akafliegslo/DragRake/(list of files, cad)

Other CAD files:
CAD/Drag Rake Assembly/91270A250_STL NONMARRING LOCKNUT WSPRING-LOCK WASHER.f3d
CAD/Drag Rake Assembly/92095A183_BUTTON HEAD HEX DRIVE SCREW.f3d
CAD/Drag Rake Assembly/Adafruit ESP8266 Feather_withPinheads.f3d
CAD/Drag Rake Assembly/Amphenol Pressure Sensor.f3d
CAD/Drag Rake Assembly/Carbon Frame.f3d
CAD/Drag Rake Assembly/DR Assembly V2.f3z
CAD/Drag Rake Assembly/Free stream tube.f3d
CAD/Drag Rake Assembly/Rake Body Drawing V2.f3z
CAD/Drag Rake Assembly/Rake Tube.f3d
CAD/Drag Rake Assembly/Tubing Connect.f3d
