akafliegslo/DragRake/CAD/DR_Assembly_V2_2020-Jan-13_07-56-52AM-000_CustomizedView37132953606.png

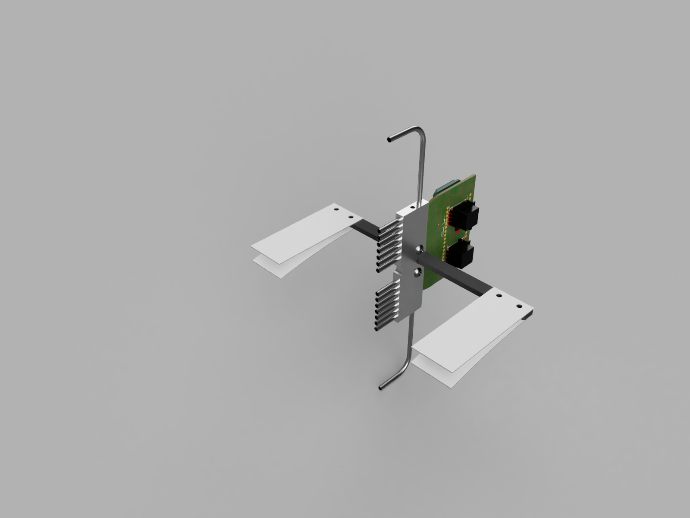
CAD/DR_Assembly_V2_2020-Jan-13_07-56-52AM-000_CustomizedView37132953606.png
