akafliegslo/DragRake/CAD/DR_Assembly_V2_2020-Jan-13_08-01-58AM-000_CustomizedView126981086.png

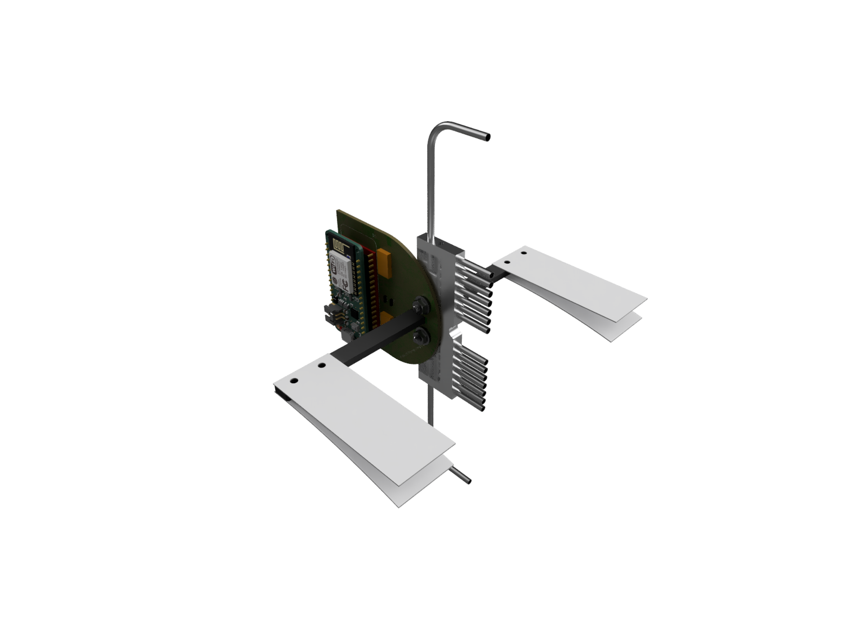
CAD/DR_Assembly_V2_2020-Jan-13_08-01-58AM-000_CustomizedView126981086.png
