akafliegslo/DragRake/Test Data and Analysis/AoA Analysis/Av_Pressure_vs_AoA.png

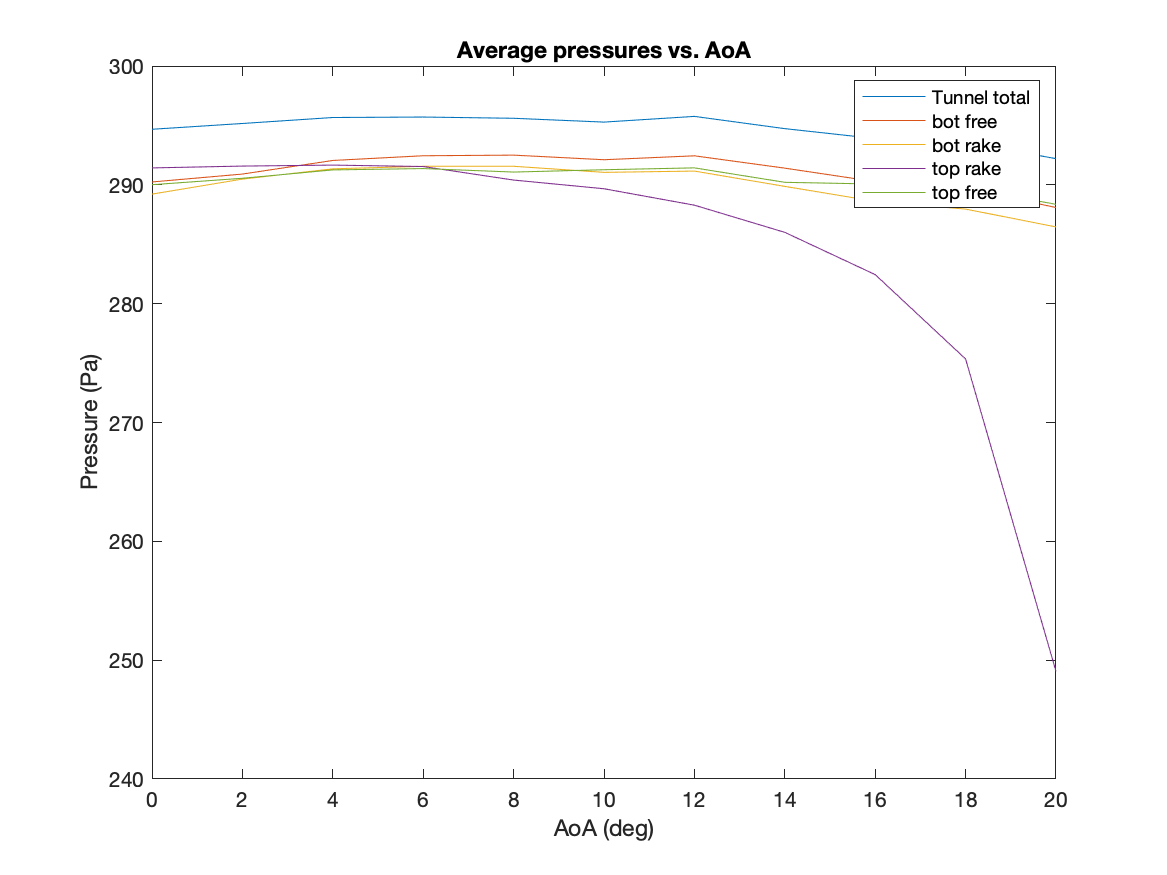
Test Data and Analysis/AoA Analysis/Av_Pressure_vs_AoA.png
