akafliegslo/DragRake/Test Data and Analysis/dr2_22_0d.png

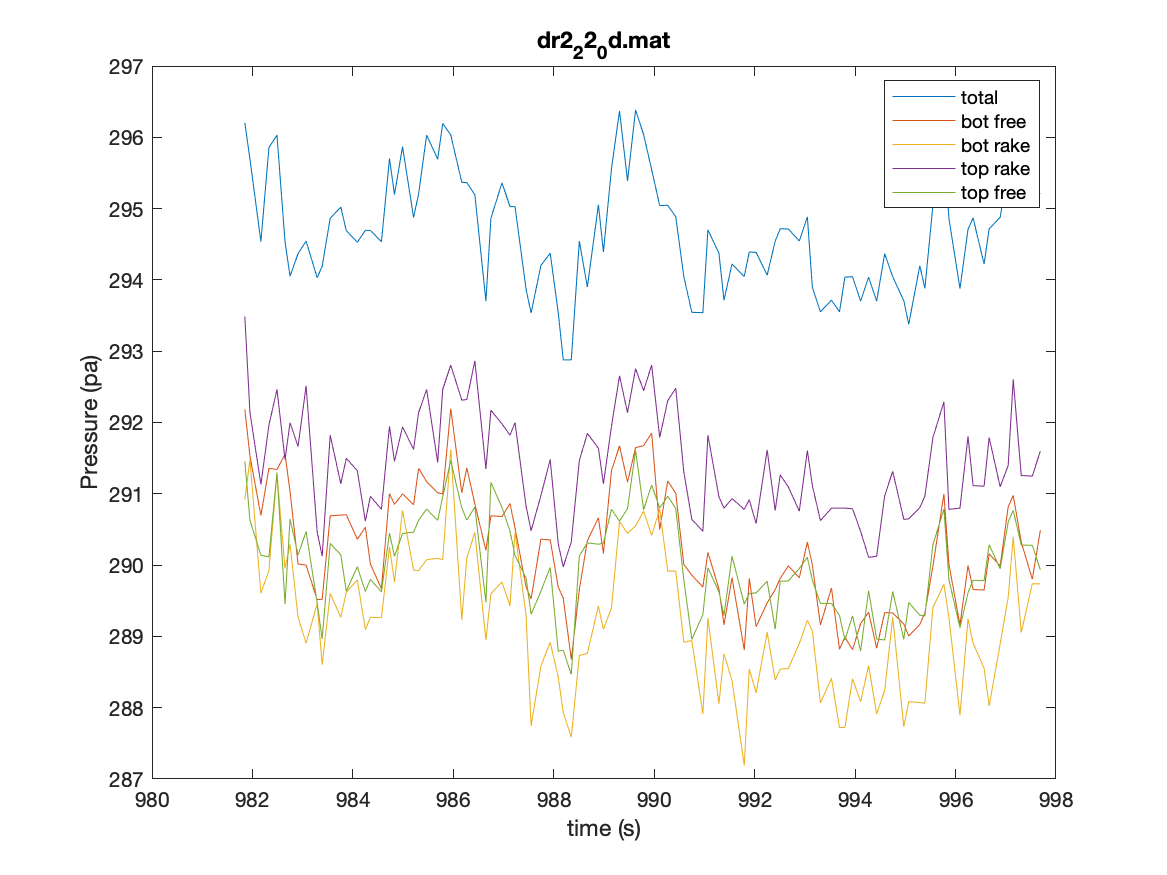
Test Data and Analysis/dr2_22_0d.png
