akafliegslo/DragRake/Test Data and Analysis/dr2_22_2d.png

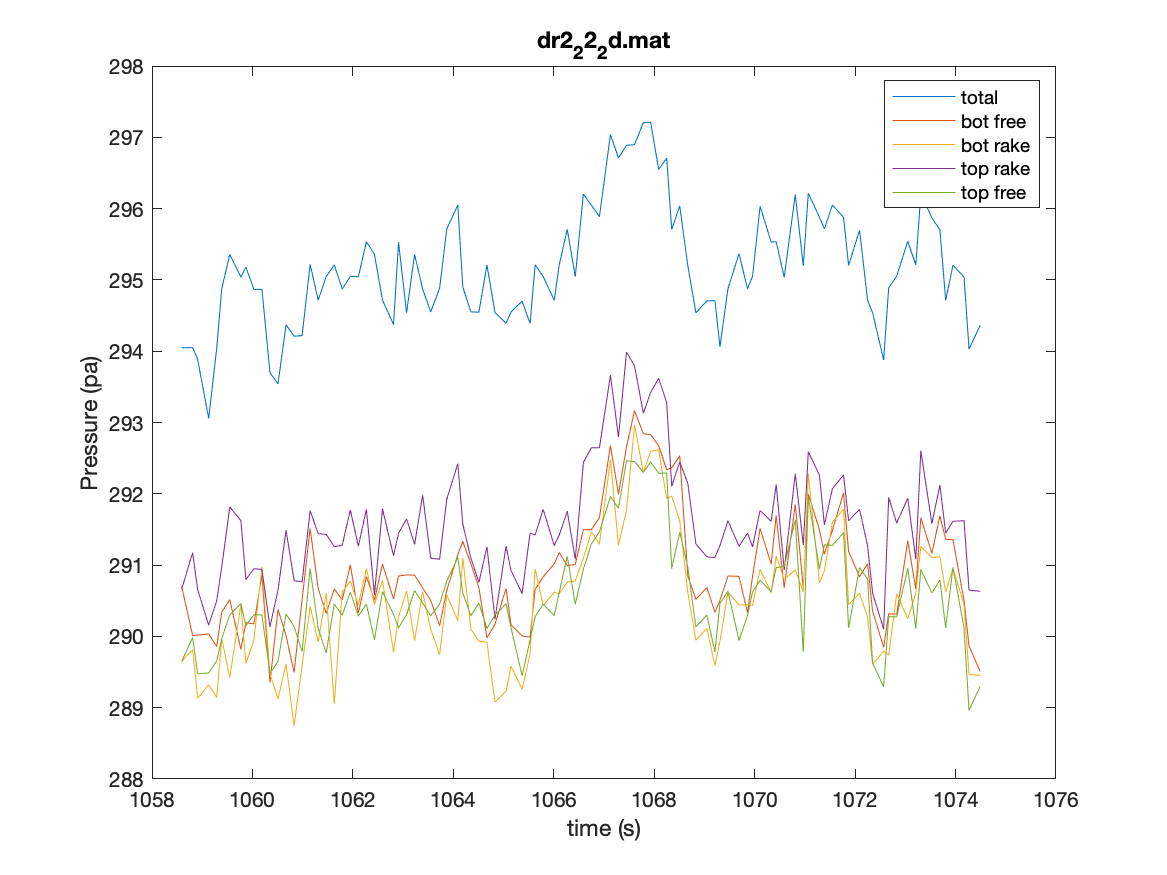
Test Data and Analysis/dr2_22_2d.png
