akafliegslo/DragRake/Test Data and Analysis/dr2_22_4d.png

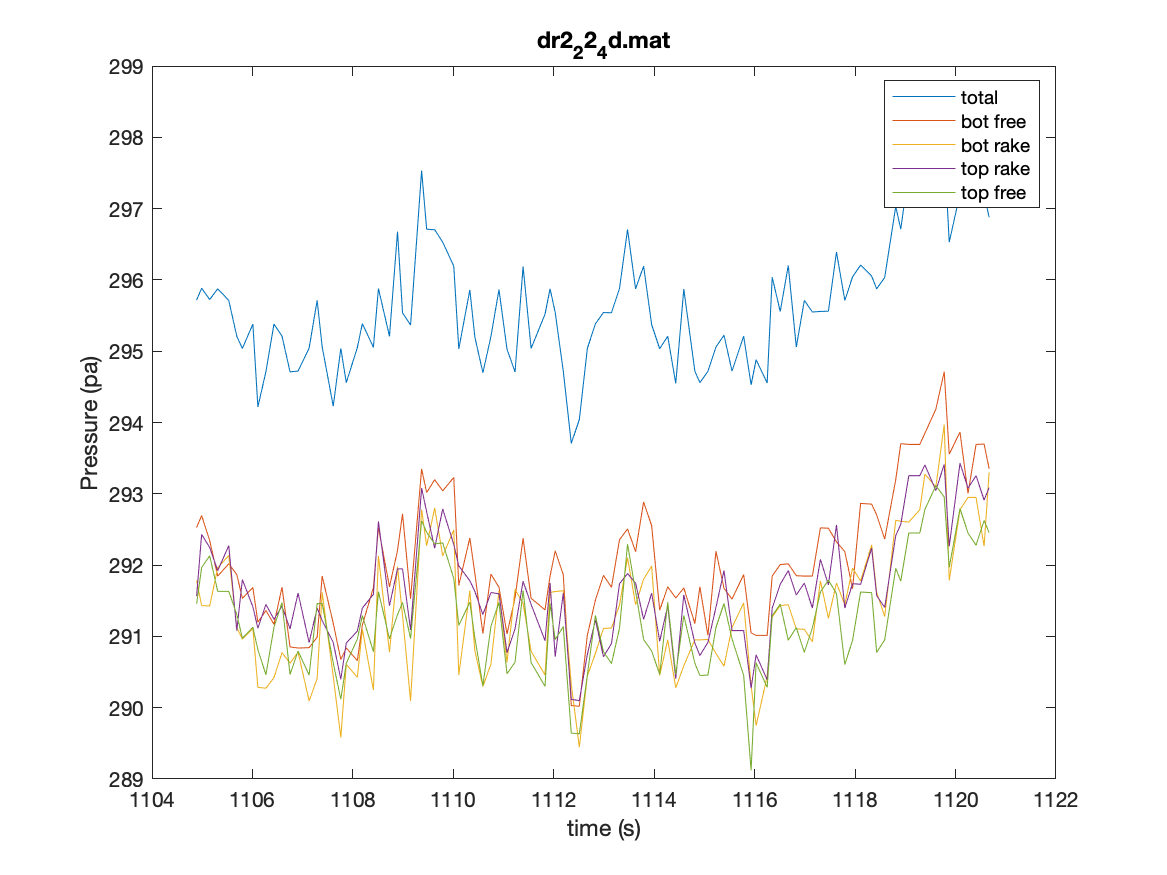
Test Data and Analysis/dr2_22_4d.png
