akafliegslo/DragRake/Test Data and Analysis/dr2_22_6d.png

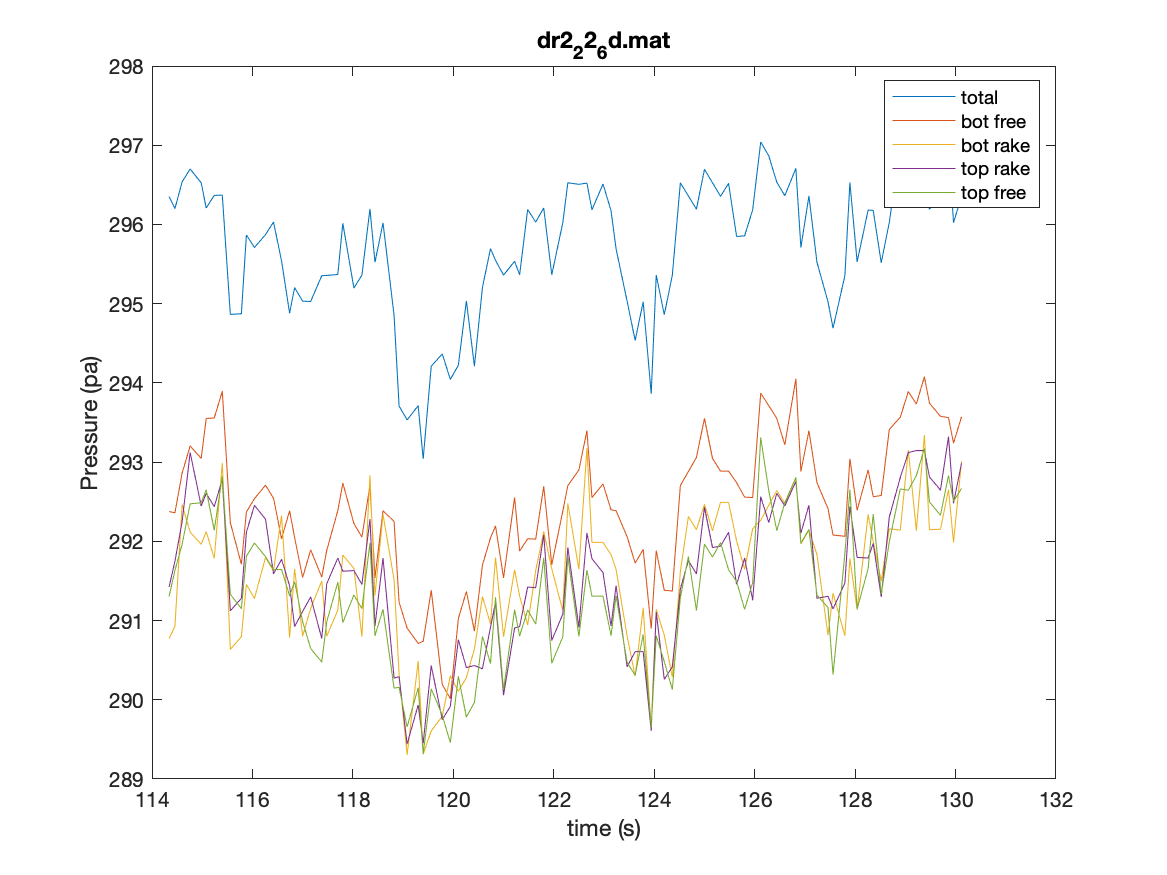
Test Data and Analysis/dr2_22_6d.png
