akafliegslo/DragRake/Test Data and Analysis/dr2_22_8d.png

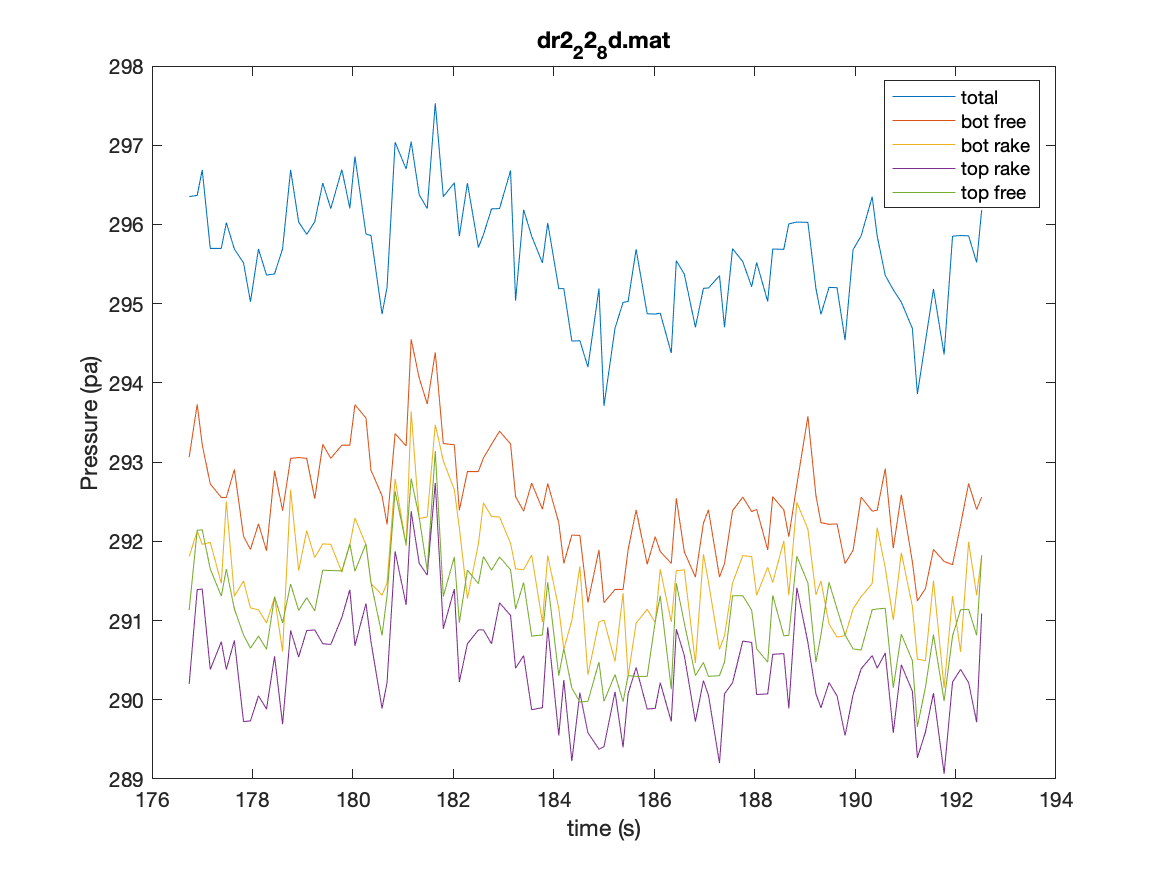
Test Data and Analysis/dr2_22_8d.png
