akafliegslo/DragRake/Test Data and Analysis/dr2_22_10d.png

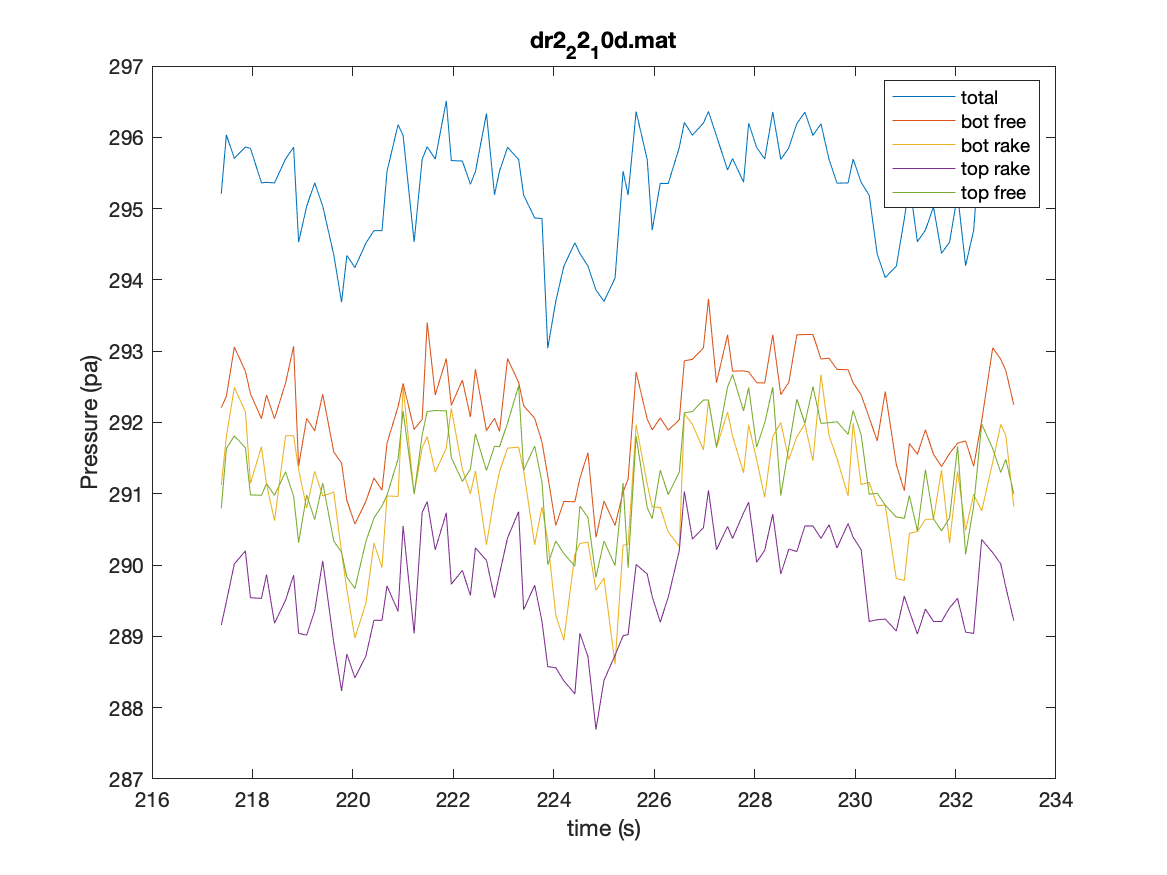
Test Data and Analysis/dr2_22_10d.png
