akafliegslo/DragRake/Test Data and Analysis/dr2_22_12d.png

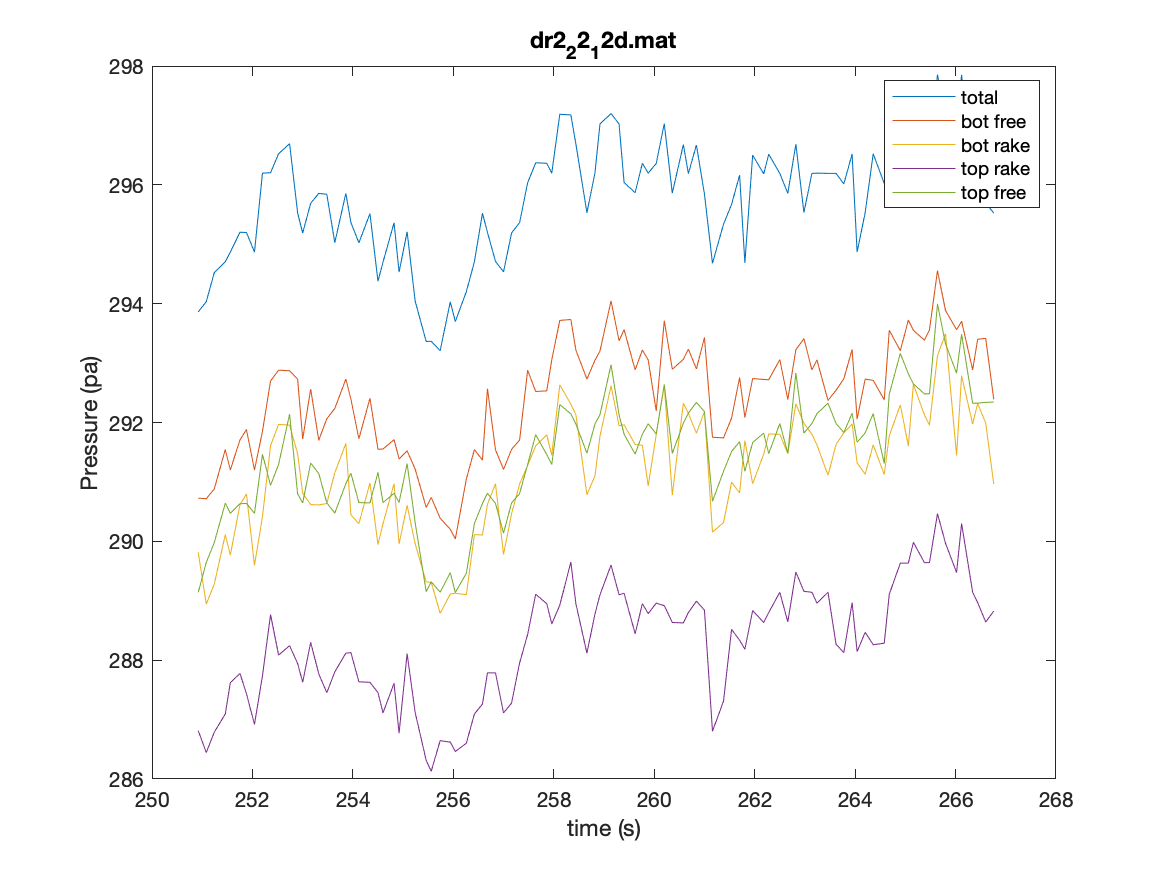
Test Data and Analysis/dr2_22_12d.png
