akafliegslo/DragRake/Test Data and Analysis/dr2_22_14d.png

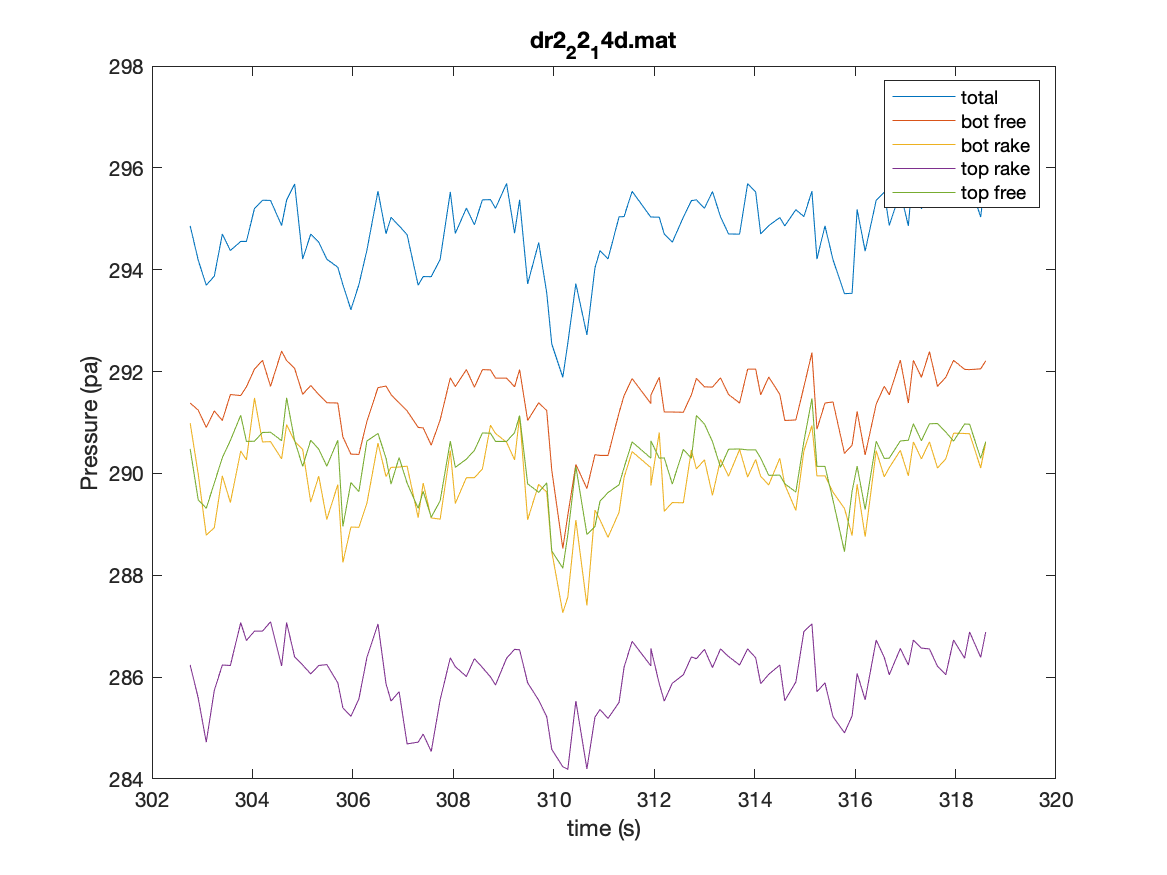
Test Data and Analysis/dr2_22_14d.png
