akafliegslo/DragRake/Test Data and Analysis/dr2_22_16d.png

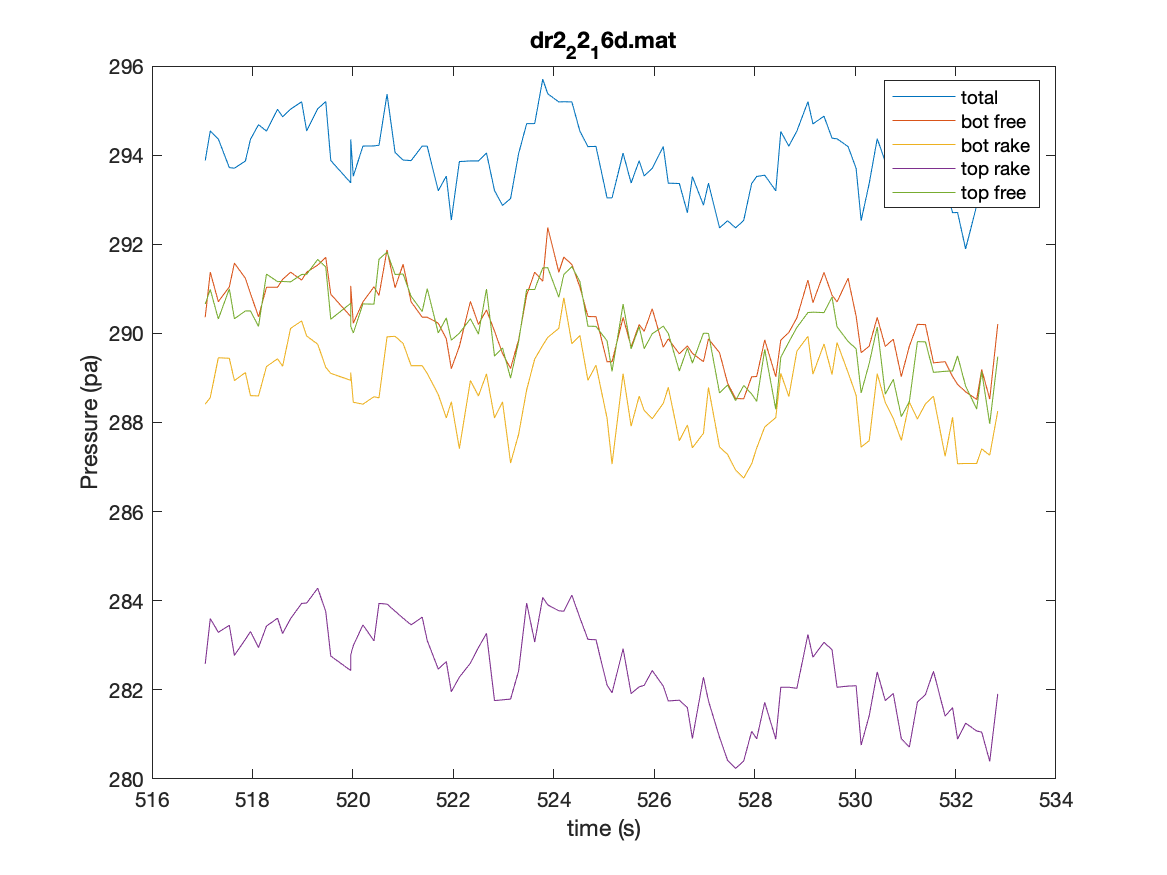
Test Data and Analysis/dr2_22_16d.png
