akafliegslo/DragRake/Test Data and Analysis/dr2_22_18d.png

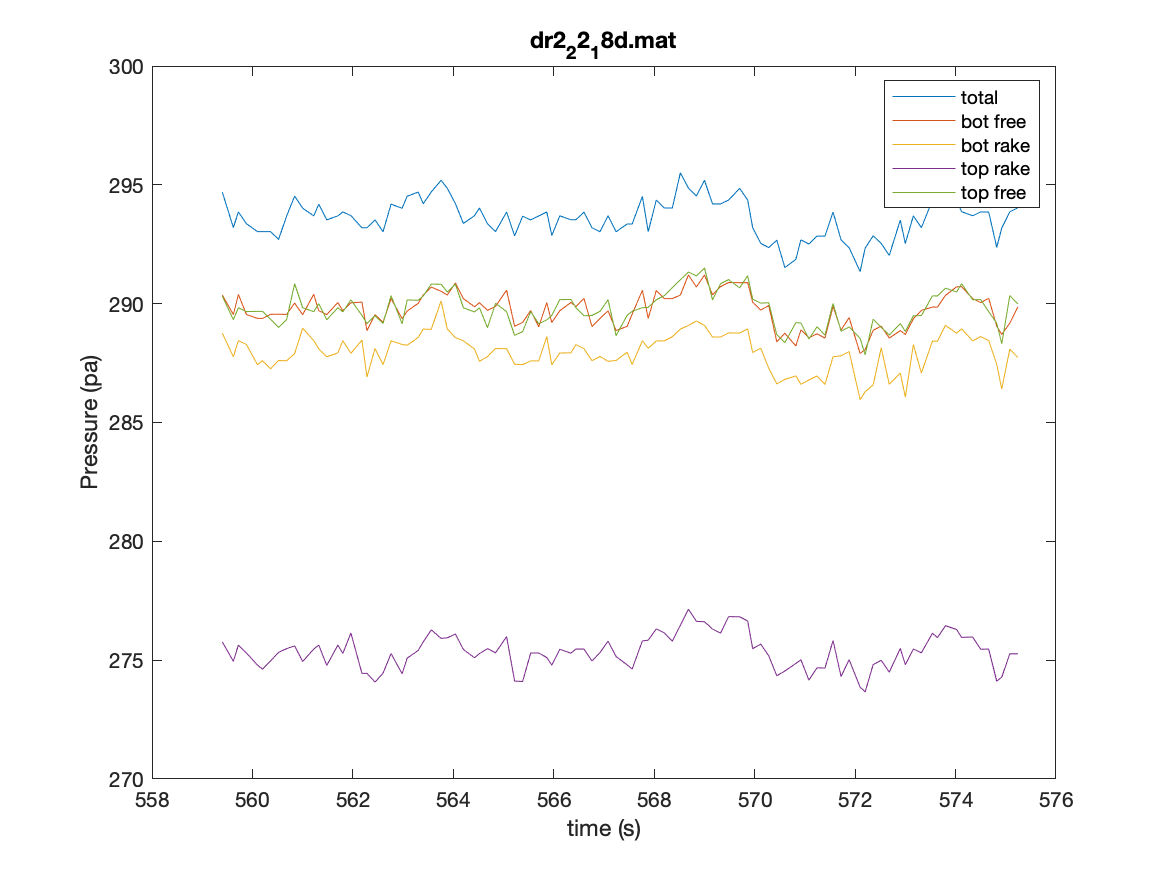
Test Data and Analysis/dr2_22_18d.png
