akafliegslo/DragRake/Test Data and Analysis/dr2_22_20d.png

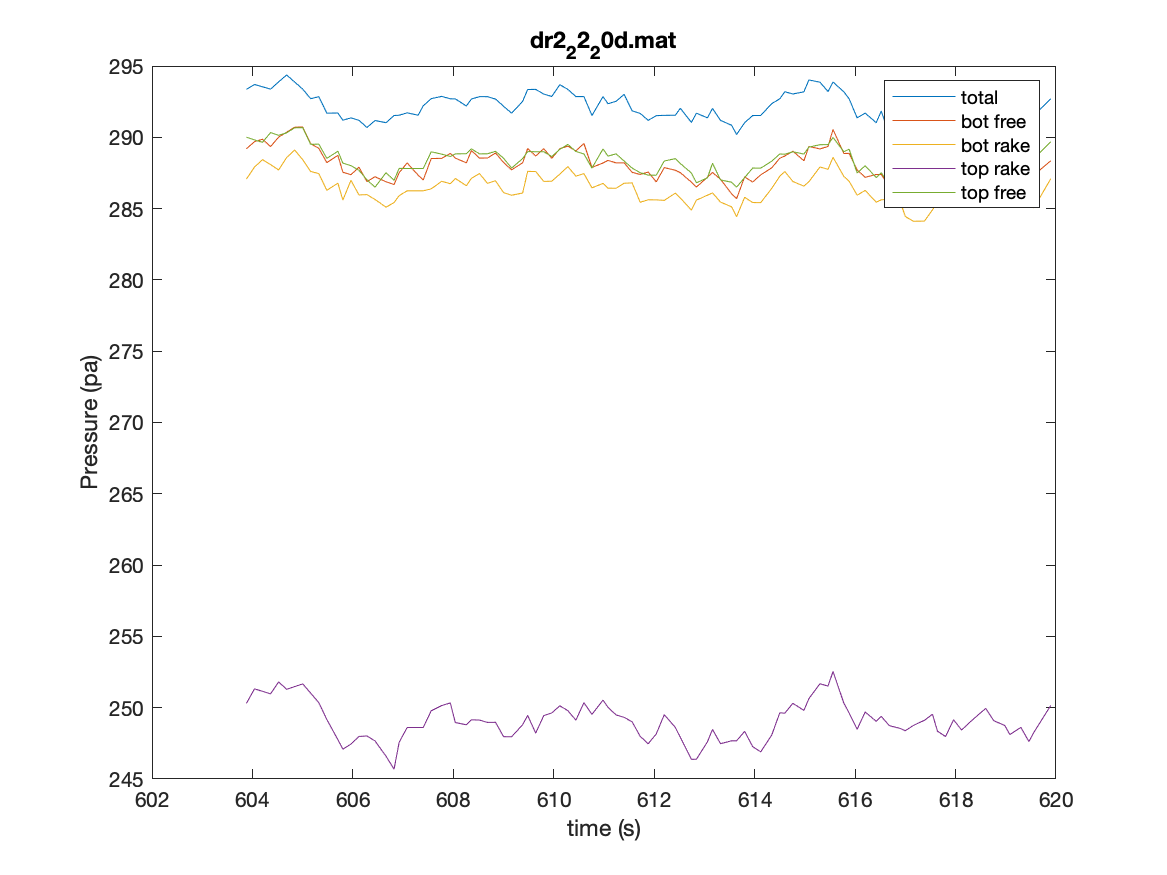
Test Data and Analysis/dr2_22_20d.png
