akafliegslo/DragRake/Test Data and Analysis/dr_11.5_0c.png

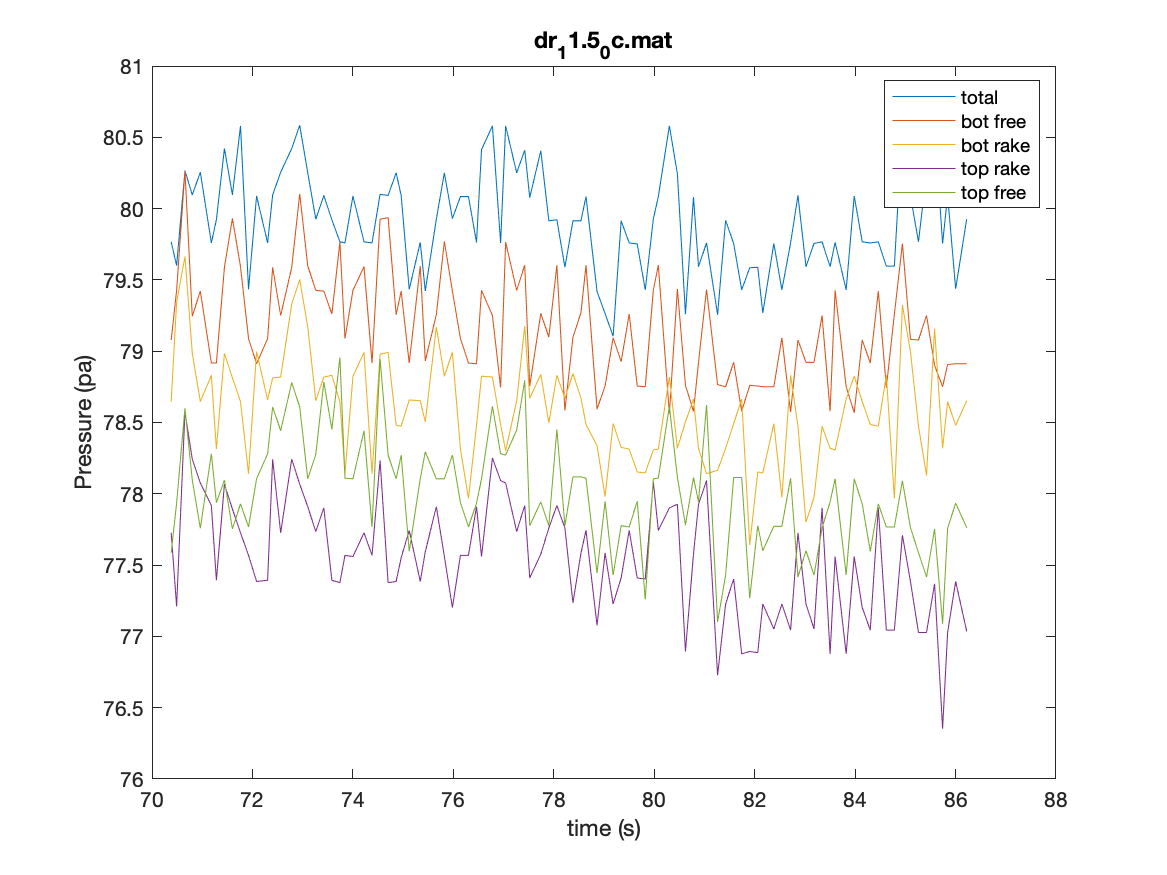
Test Data and Analysis/dr_11.5_0c.png
