akafliegslo/DragRake/Test Data and Analysis/Pressure plots/dr_11.5_0d.png

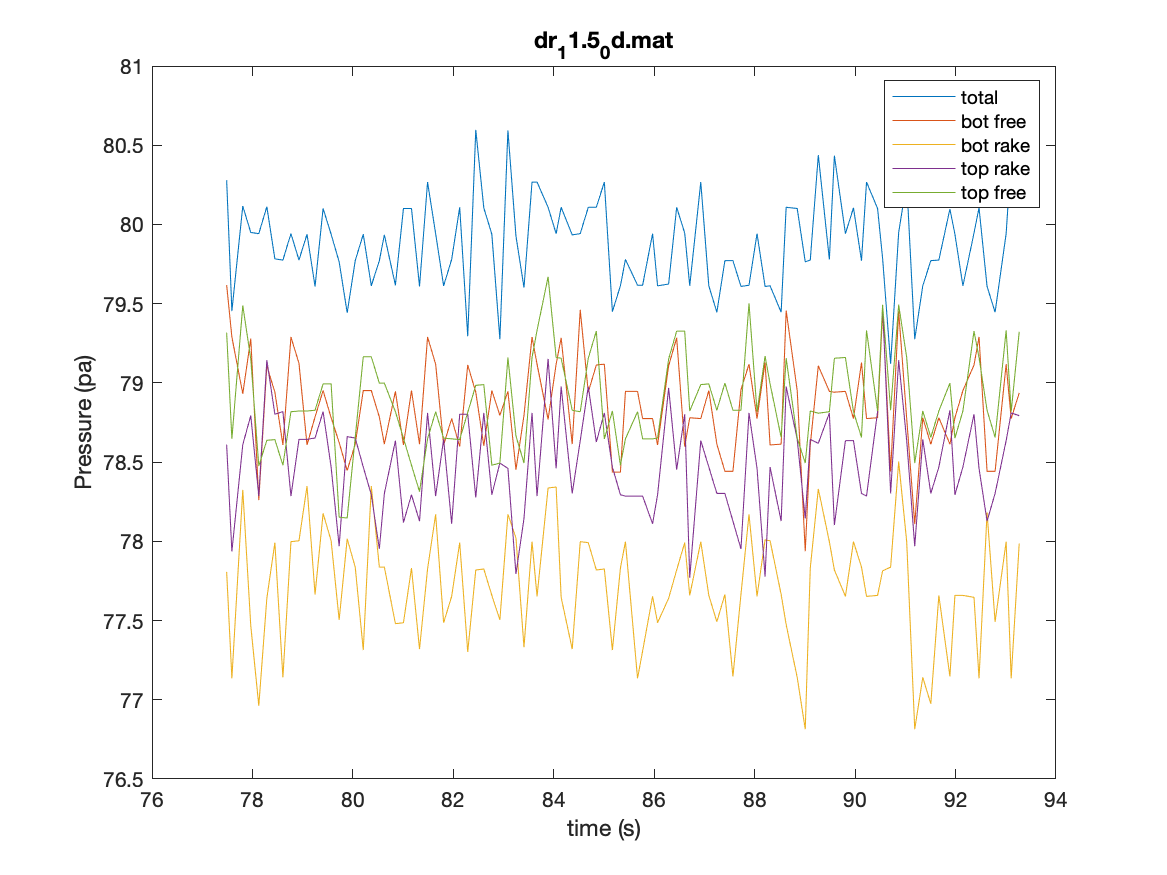
Test Data and Analysis/Pressure plots/dr_11.5_0d.png
