akafliegslo/DragRake/Test Data and Analysis/Pressure plots/dr_16_0c.png

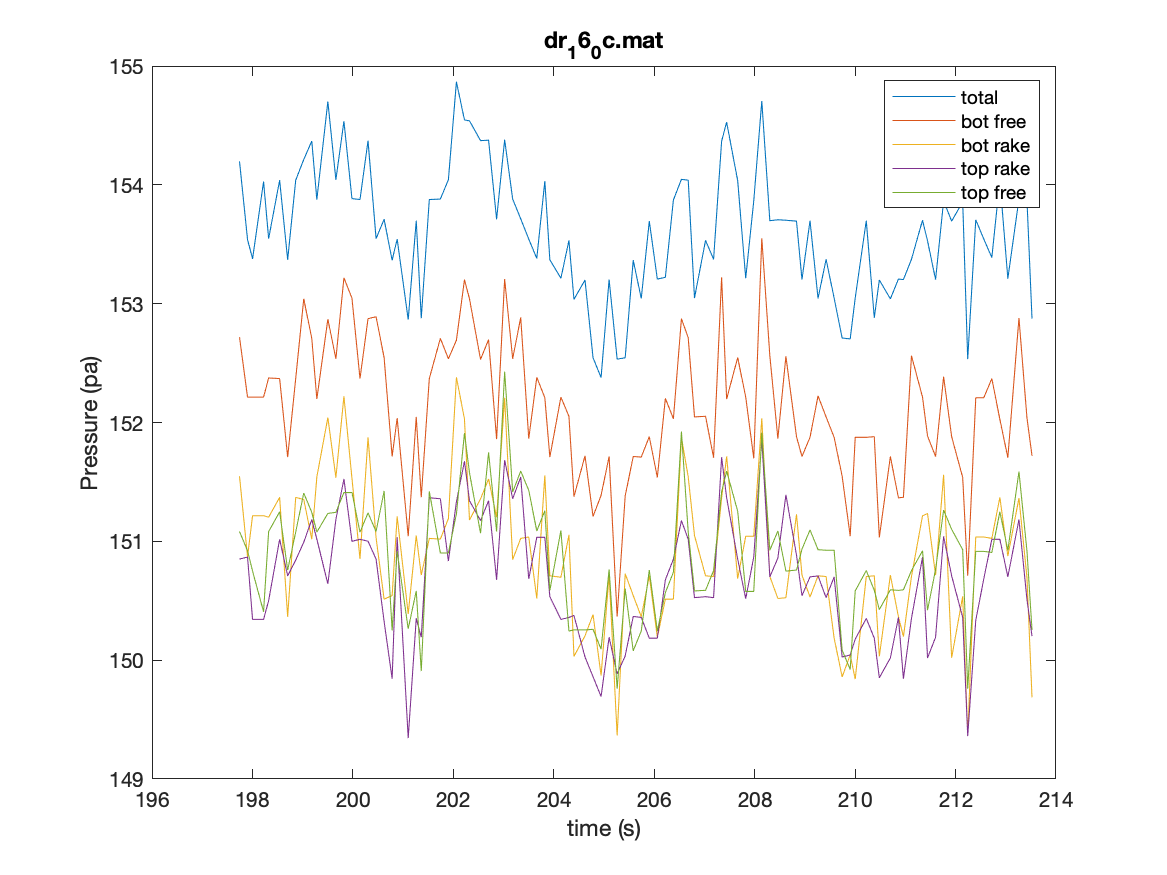
Test Data and Analysis/Pressure plots/dr_16_0c.png
