akafliegslo/DragRake/Test Data and Analysis/Pressure plots/dr_16_0d.png

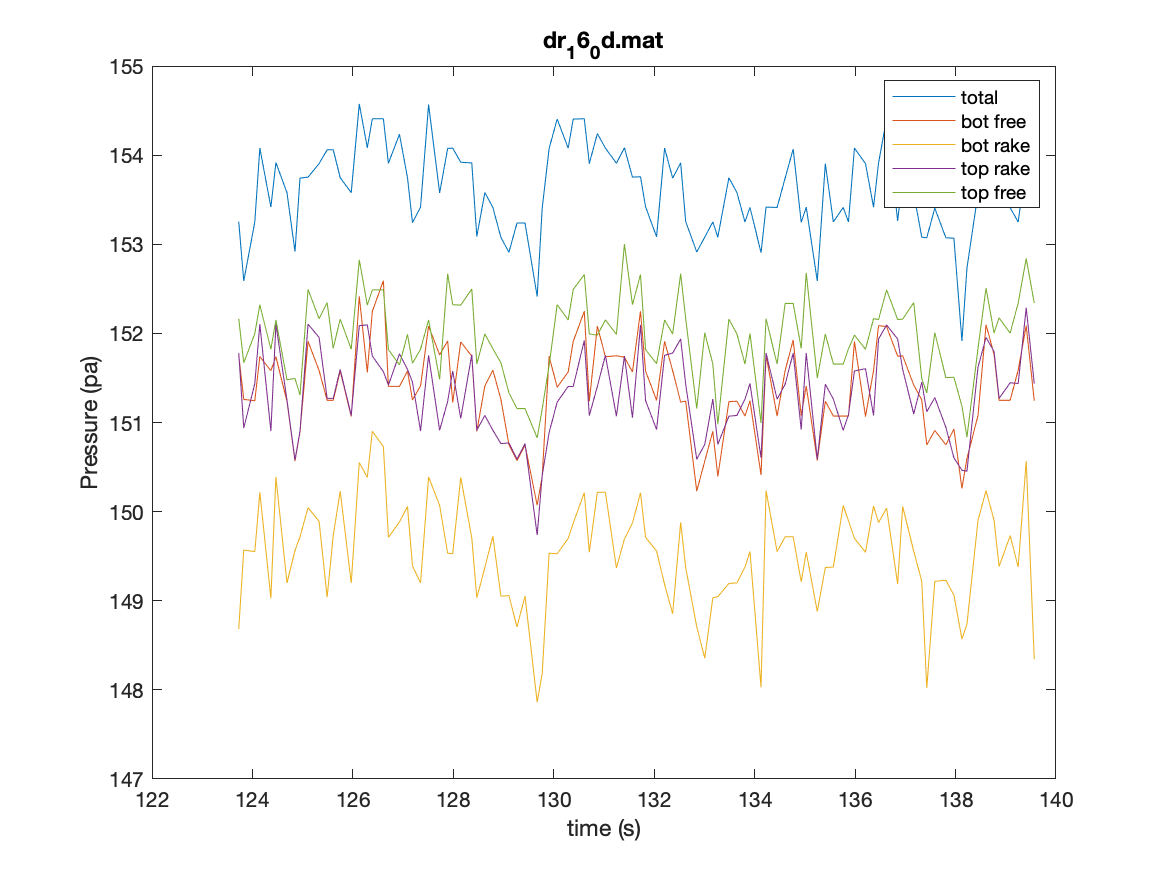
Test Data and Analysis/Pressure plots/dr_16_0d.png
