akafliegslo/DragRake/Test Data and Analysis/Pressure plots/dr_22_0c.png

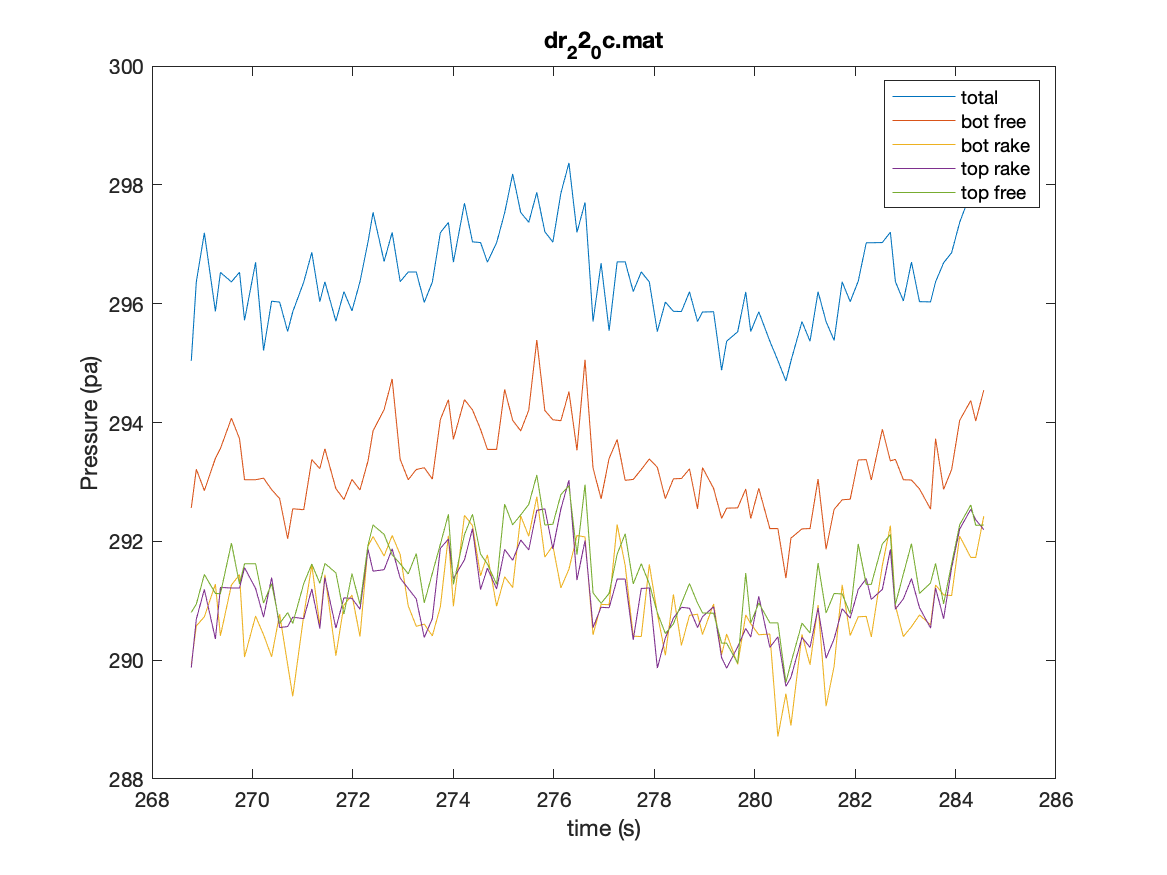
Test Data and Analysis/Pressure plots/dr_22_0c.png
