akafliegslo/DragRake/Test Data and Analysis/Pressure plots/dr_22_0d.png

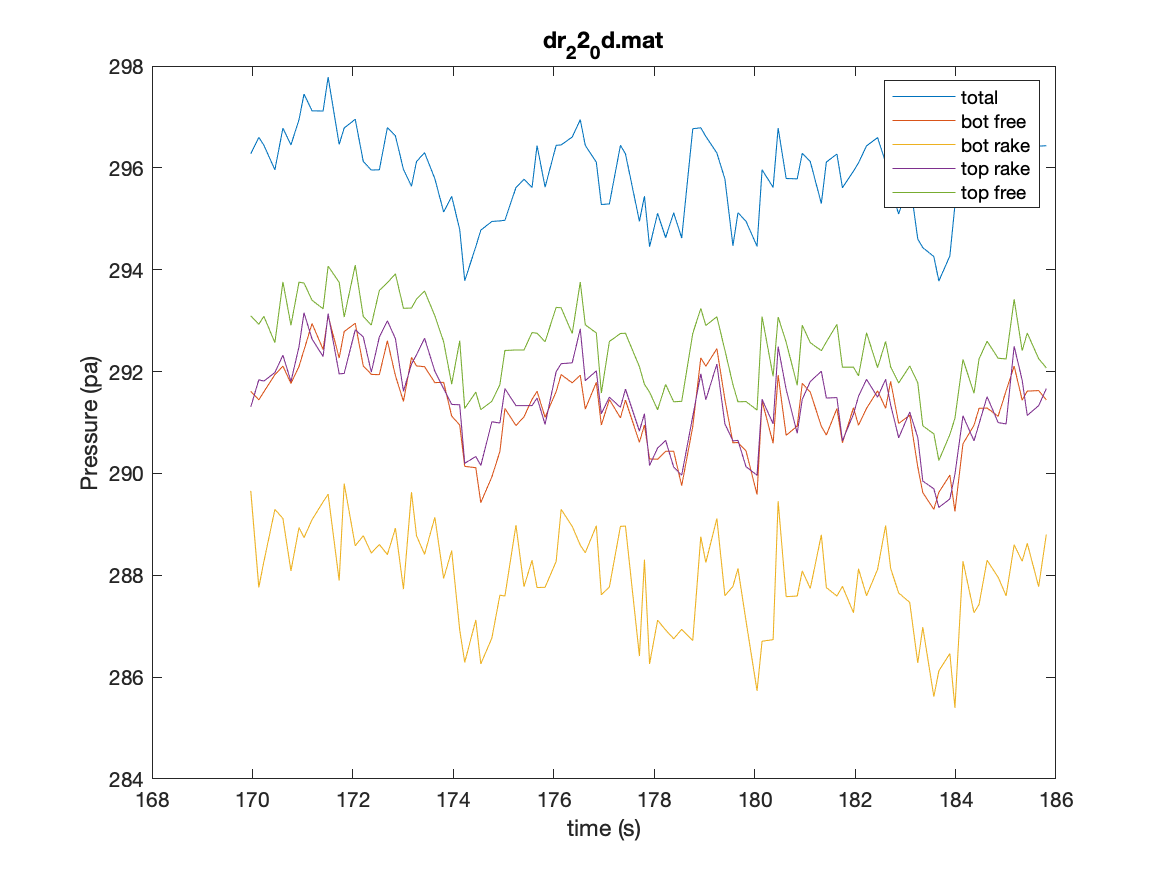
Test Data and Analysis/Pressure plots/dr_22_0d.png
