akafliegslo/DragRake/Test Data and Analysis/Pressure plots/dr_27_0c.png

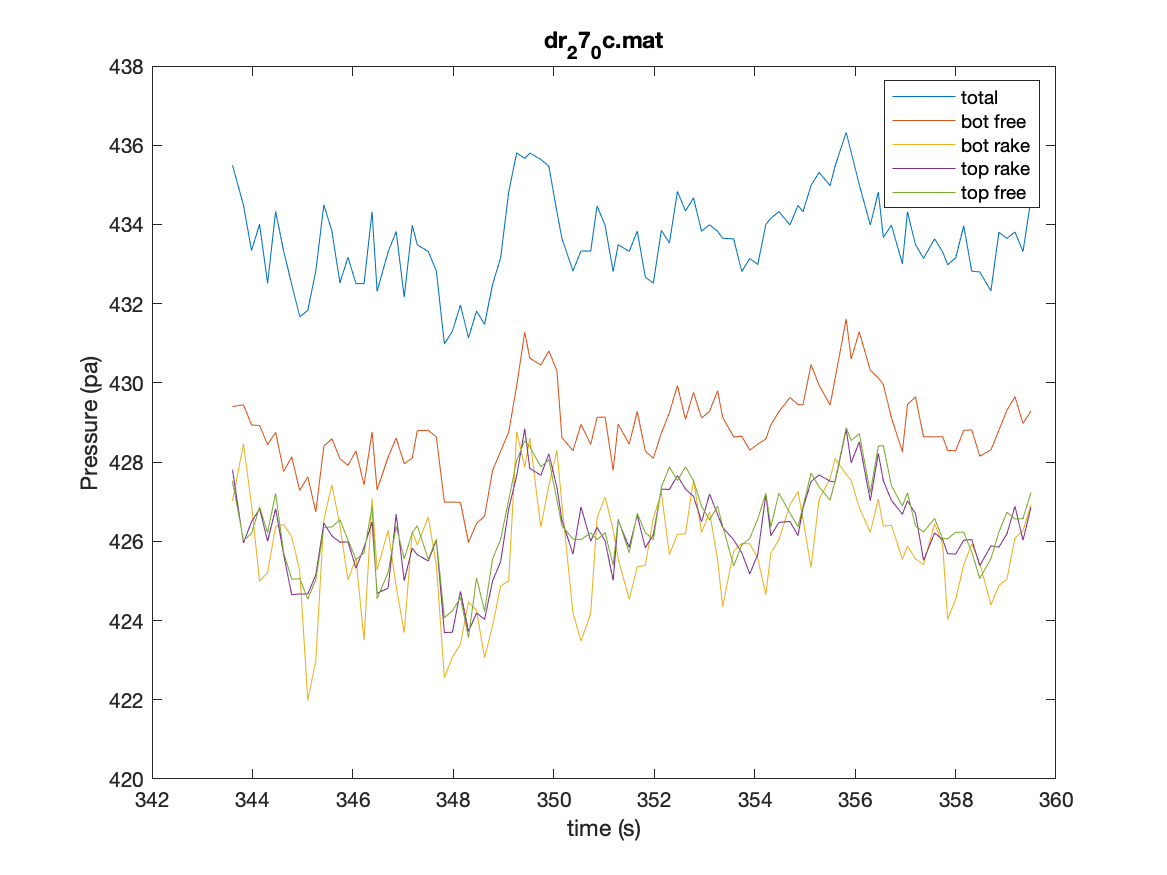
Test Data and Analysis/Pressure plots/dr_27_0c.png
