akafliegslo/DragRake/Test Data and Analysis/Pressure plots/dr_27_0d.png

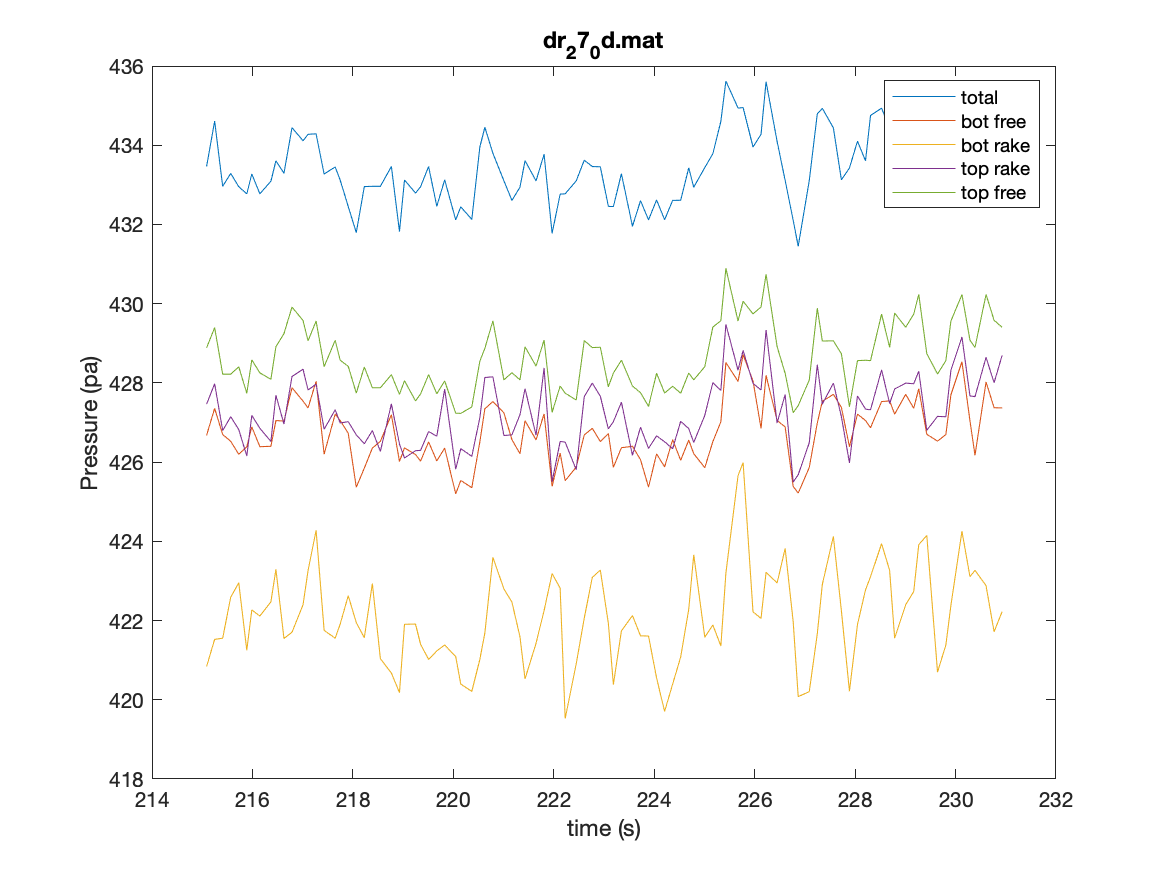
Test Data and Analysis/Pressure plots/dr_27_0d.png
