akafliegslo/DragRake/Test Data and Analysis/Pressure plots/dr_32_0c.png

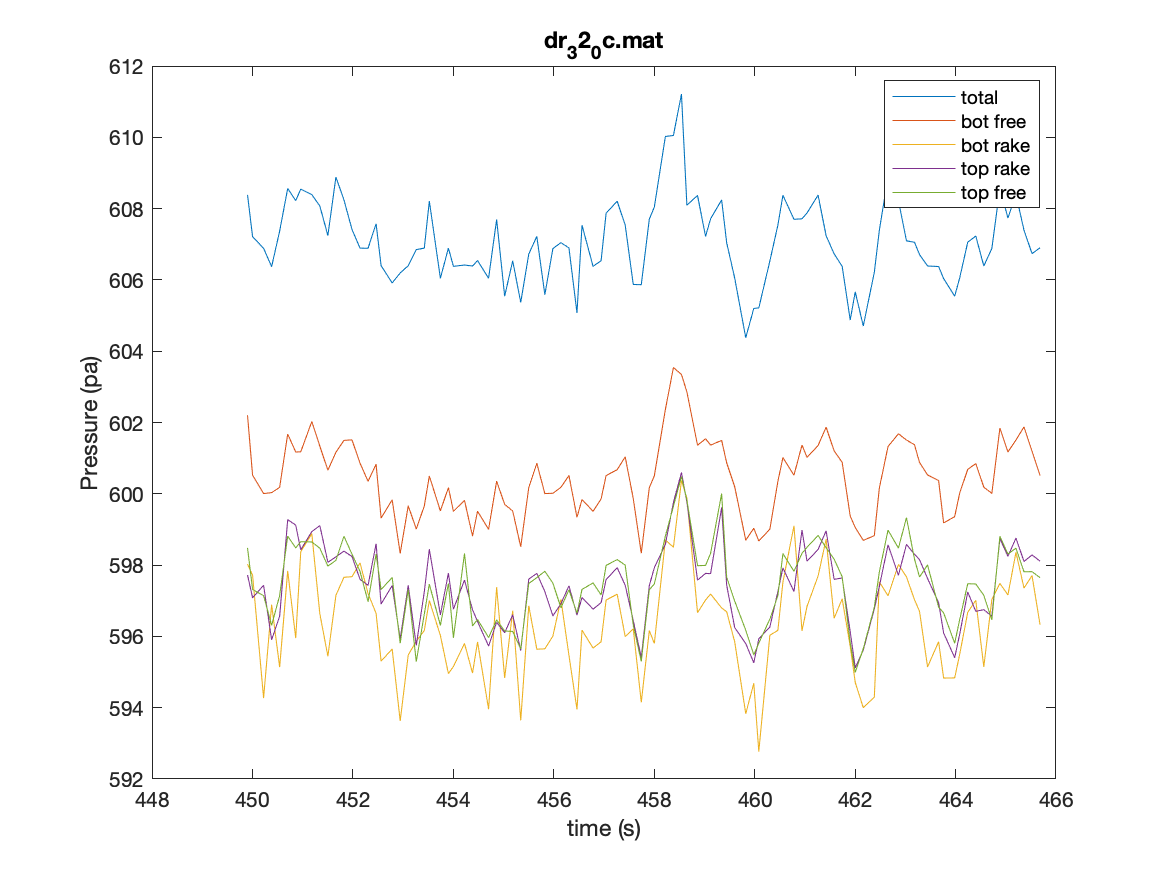
Test Data and Analysis/Pressure plots/dr_32_0c.png
