akafliegslo/DragRake/Test Data and Analysis/Pressure plots/dr_32_0d.png

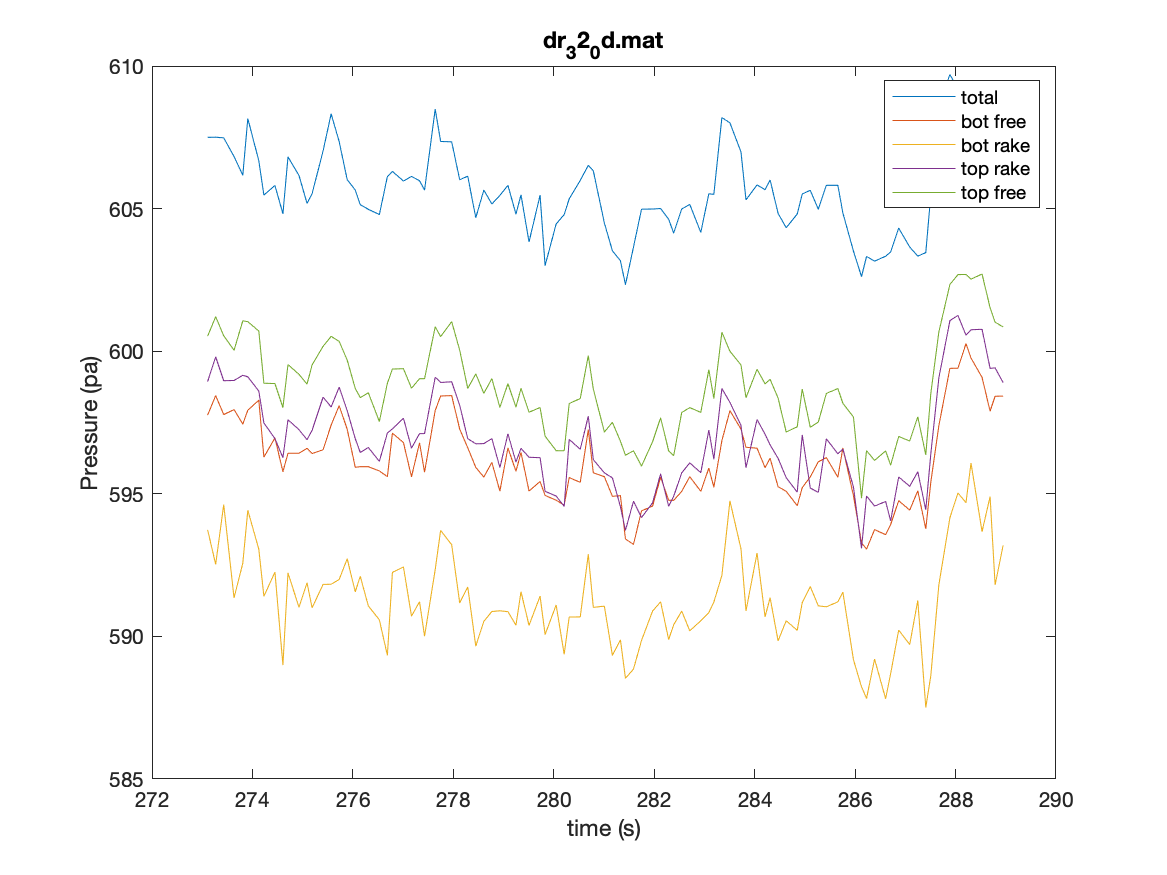
Test Data and Analysis/Pressure plots/dr_32_0d.png
