akafliegslo/DragRake/Test Data and Analysis/Pressure plots/dr_37_0c.png

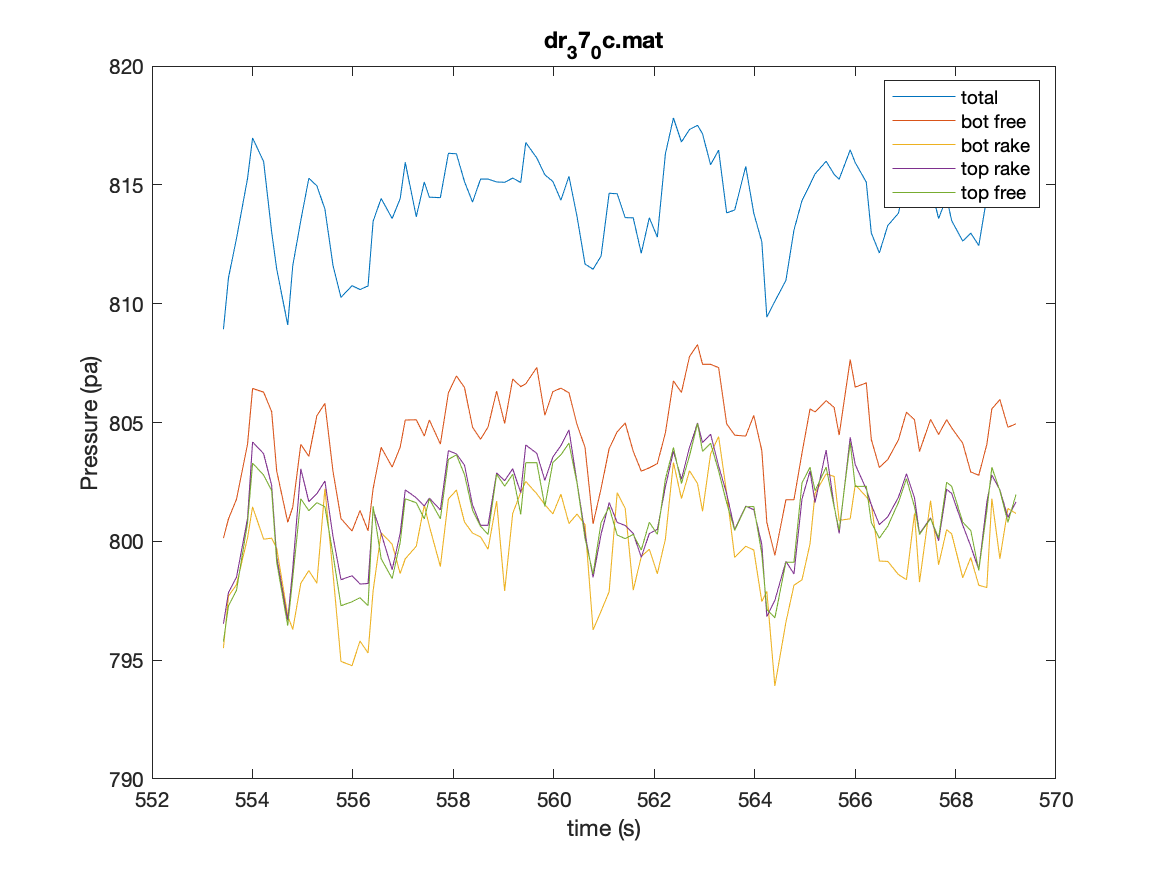
Test Data and Analysis/Pressure plots/dr_37_0c.png
