akafliegslo/DragRake/Test Data and Analysis/Pressure plots/dr_37_0d.png

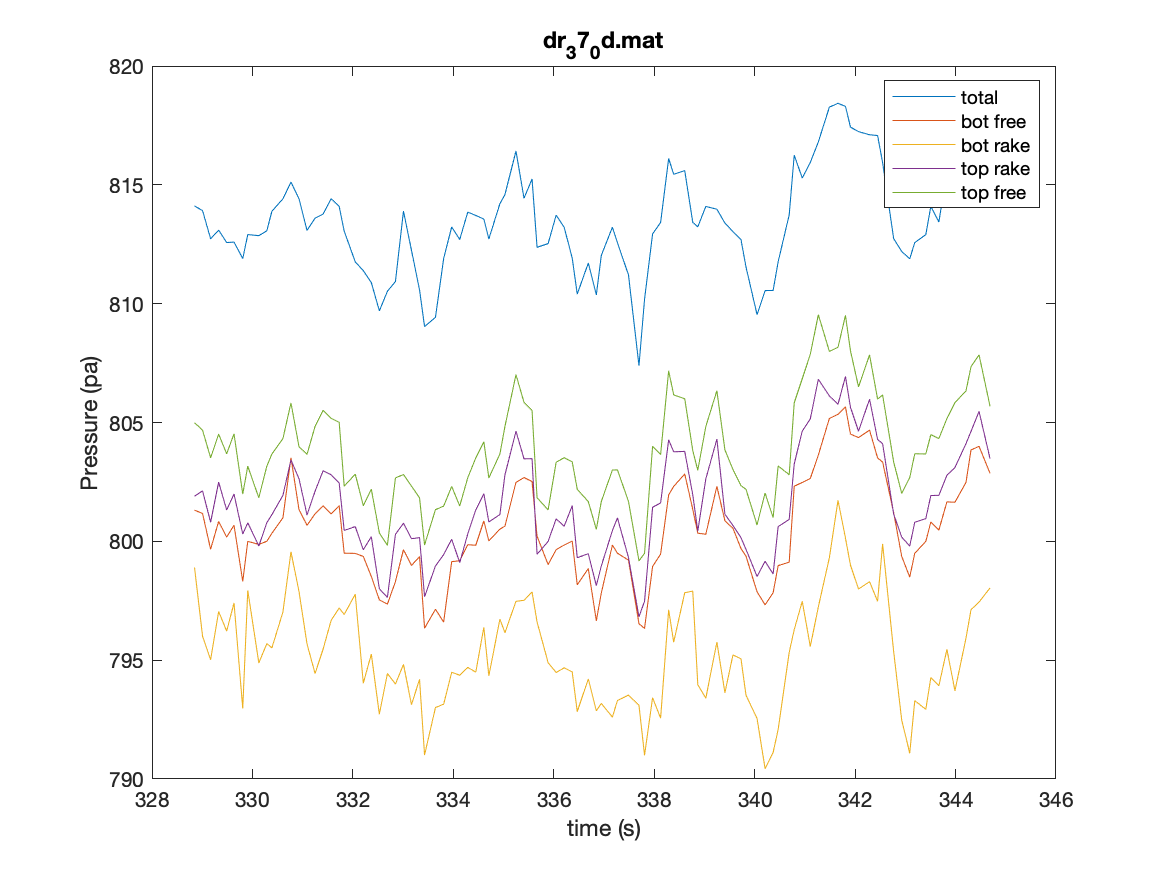
Test Data and Analysis/Pressure plots/dr_37_0d.png
