akafliegslo/DragRake/Test Data and Analysis/Pressure plots/dr_42_0c.png

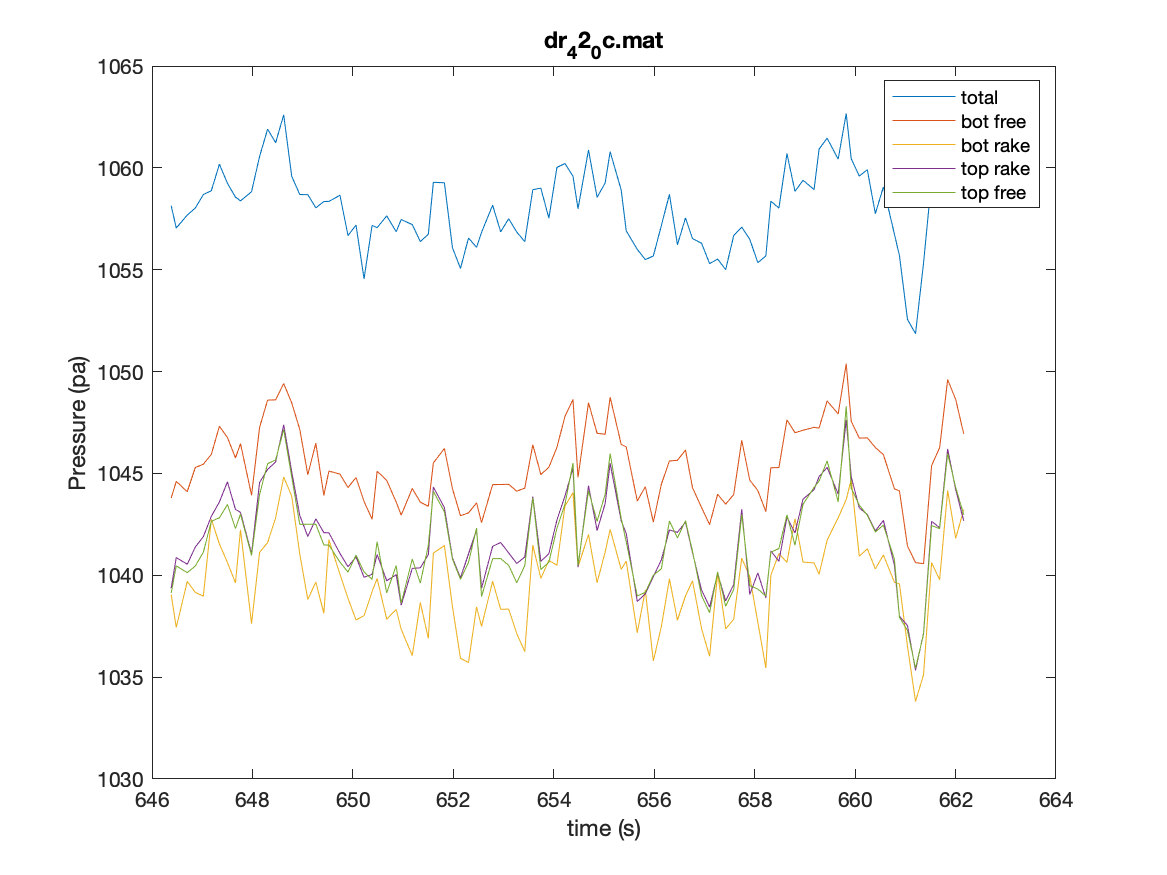
Test Data and Analysis/Pressure plots/dr_42_0c.png
