akafliegslo/DragRake/Test Data and Analysis/Pressure plots/dr_42_0d.png

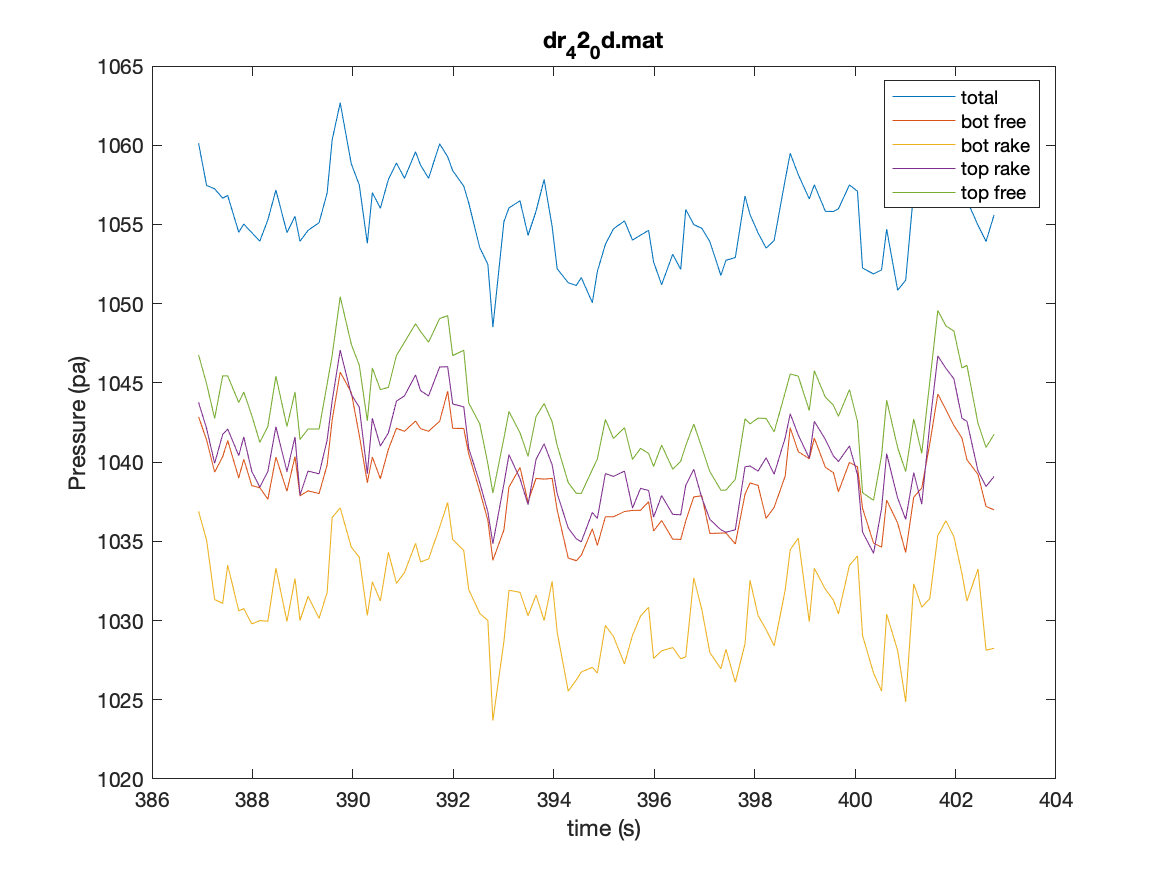
Test Data and Analysis/Pressure plots/dr_42_0d.png
