akafliegslo/DragRake/(threads)

Thread 1 (2020-01-09):

To do

Aerotusk, 2020-01-09:
End Bernoulli
Fix pressure values:
     Go directly from the datasheet, values will probably be correct
In Request Data function:
     Bottom of code
No more buttons
     Make averaging mode variable easier to locate and change
Just pressure differential
     Upload that to the website instead of speed

Thread 4 (2020-02-18):

Website still crashes

Aerotusk, 2020-02-18:
When more than a few buttons are pressed, website crashes. Probably an issue with selecting a button while I2C bus is active
