akafliegslo/DragRake/PCB/pcb project.brd

## EAGLE design PCB/pcb project.brd (2020-08-06)

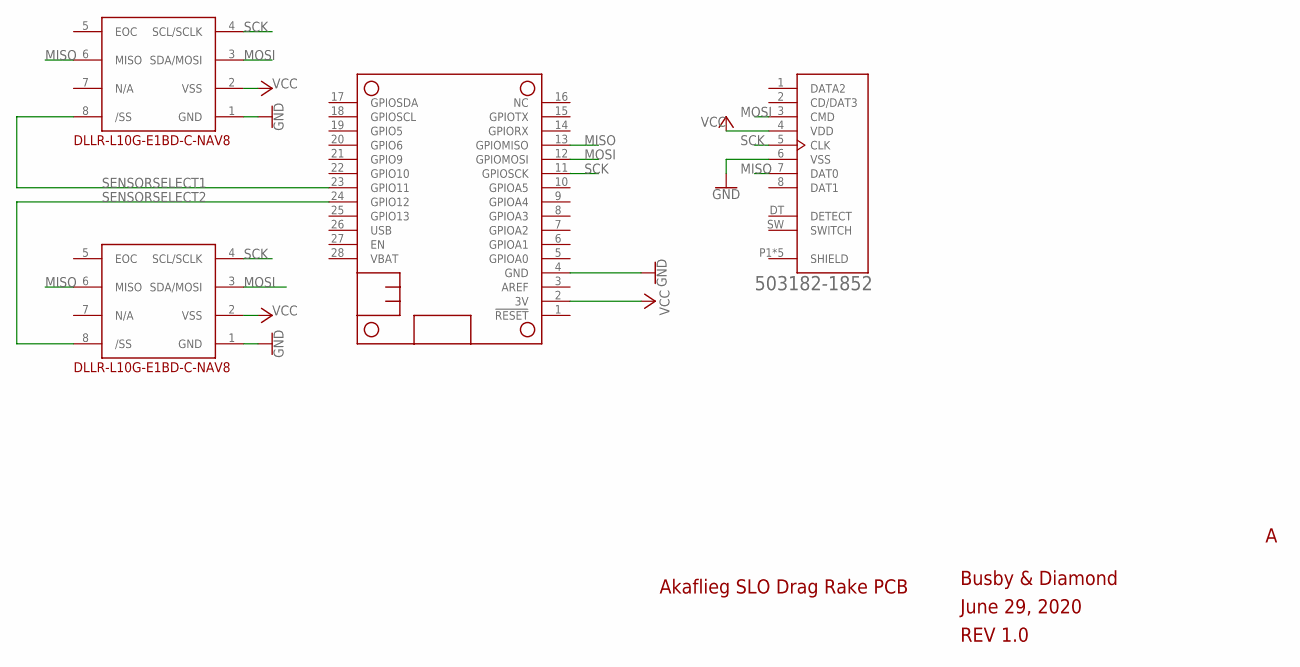
[picture p45: schematic pcb project.sch]

Parts:
DLLR-L10G-E1BD-C-NAV8_BOT: DLLR-L10G-E1BD-C-NAV8_BOT; DLLR-L10G-E1BD-C-NAV8
DLLR-L10G-E1BD-C-NAV8_TOP: DLLR-L10G-E1BD-C-NAV8_TOP; DLLR-L10G-E1BD-C-NAV8
MS1: FEATHERWING
SD_CARD: 503182-1852; MOLEX_503182-1852

Connections:
GND: DLLR-L10G-E1BD-C-NAV8_BOT.1 (GND), DLLR-L10G-E1BD-C-NAV8_TOP.1 (GND), MS1.4 (GND), SD_CARD.6 (VSS)
MISO: DLLR-L10G-E1BD-C-NAV8_BOT.6 (MISO), DLLR-L10G-E1BD-C-NAV8_TOP.6 (MISO), MS1.13 (GPIOMISO), SD_CARD.7 (DAT0)
MOSI: DLLR-L10G-E1BD-C-NAV8_BOT.3 (SDA/MOSI), DLLR-L10G-E1BD-C-NAV8_TOP.3 (SDA/MOSI), MS1.12 (GPIOMOSI), SD_CARD.3 (CMD)
SCK: DLLR-L10G-E1BD-C-NAV8_BOT.4 (SCL/SCLK), DLLR-L10G-E1BD-C-NAV8_TOP.4 (SCL/SCLK), MS1.11 (GPIOSCK), SD_CARD.5 (CLK)
SENSORSELECT1: DLLR-L10G-E1BD-C-NAV8_TOP.8 (/SS), MS1.23 (GPIO11)
SENSORSELECT2: DLLR-L10G-E1BD-C-NAV8_BOT.8 (/SS), MS1.24 (GPIO12)
VCC: DLLR-L10G-E1BD-C-NAV8_BOT.2 (VSS), DLLR-L10G-E1BD-C-NAV8_TOP.2 (VSS), MS1.2 (3V), SD_CARD.4 (VDD)

Notes on the sheet:
June 29, 2020
Akaflieg SLO Drag Rake PCB
Busby & Diamond
REV 1.0

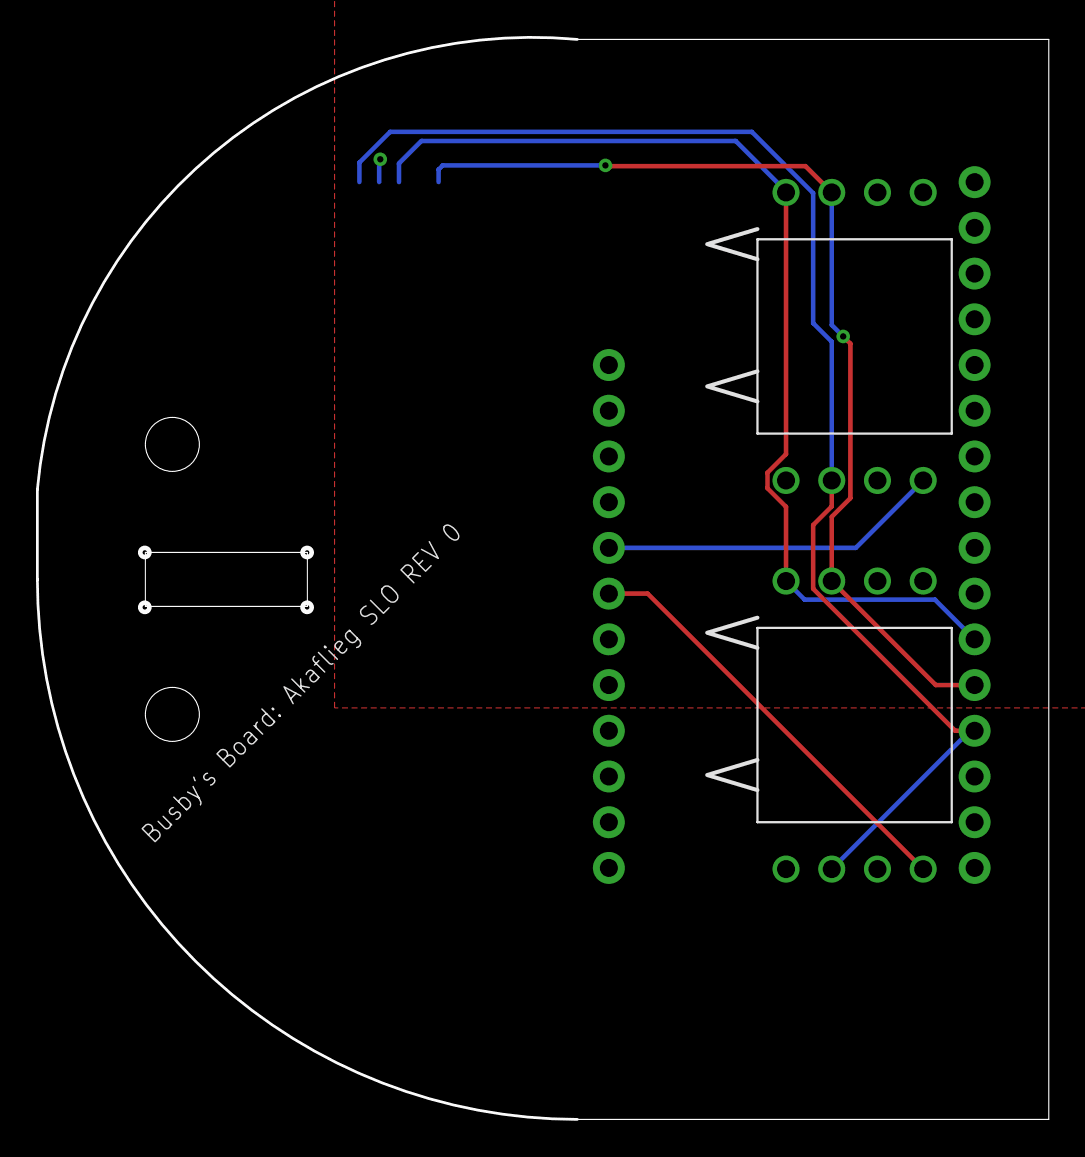
[picture p46: board pcb project.brd from above]

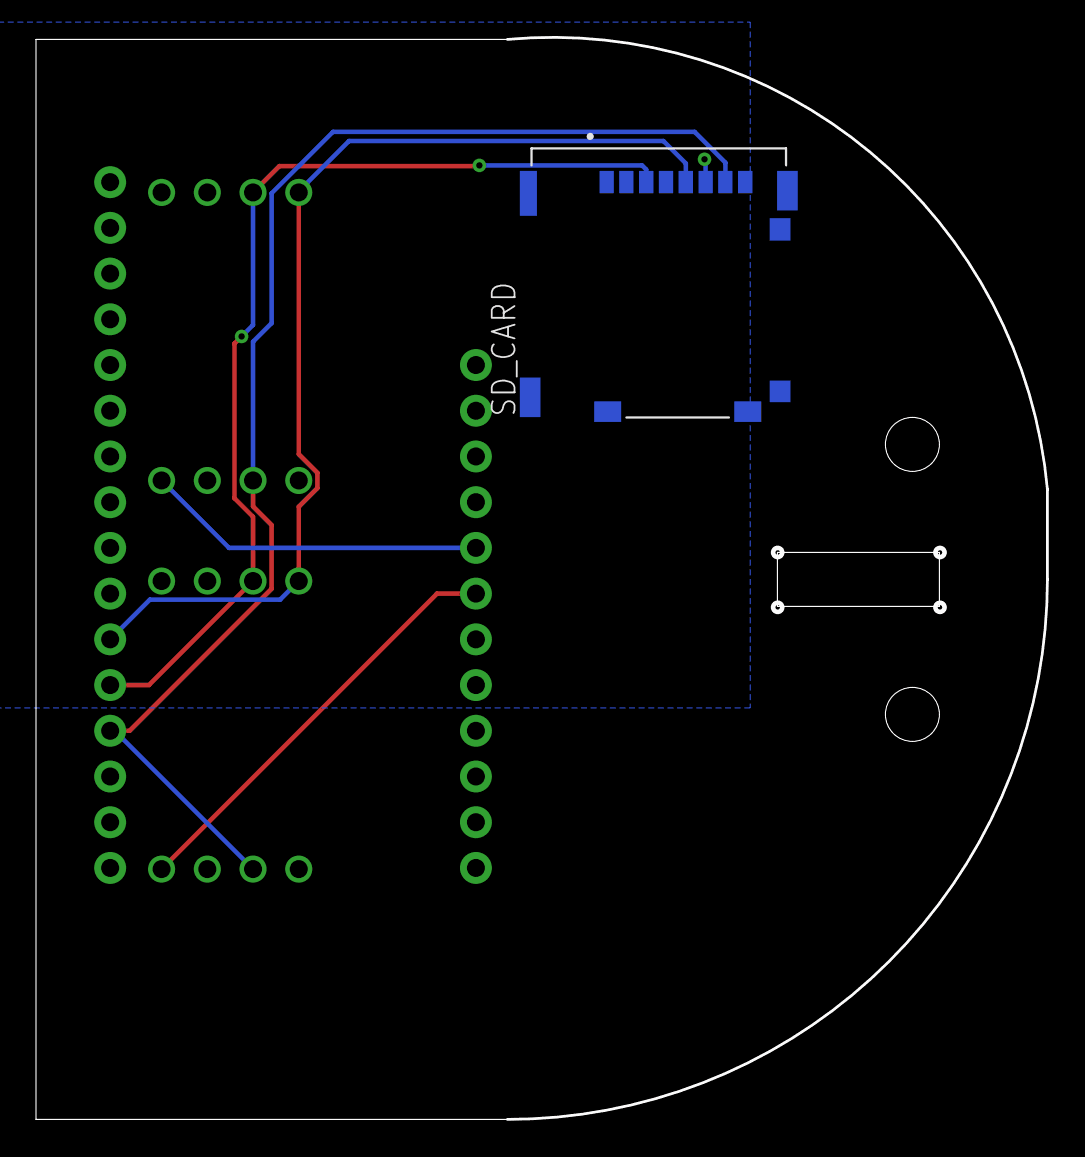
[picture p47: board pcb project.brd from below]

Board: 2 copper layers, 56.2 x 60.1 mm, 4 parts (2 on the bottom side), 7 nets.
