akafliegslo/DragRake/(commit log)

2019-10-23 Added I2C code
    Separate file as the code has not been put together yet. The I2C code can output raw pressure data to a graph using the serial plotter.
2019-11-02 Added the WIP webpage
    There's still a lot of work to be done on it, but at least for now it can read the values from human input, display which mode is selected, and (very soon) can change the mode in which the transducer operates.
    I'll work on writing some more comments and documentation for the code in a bit, but right now I'm tired and could use a break :)
2019-11-02 Removed I2C stuff that may kill transducers
2019-11-03 Added combined code`
    Basically everything has been added to this code. All that needs to happen is to get the calculations right for the sensors, and make the two sensor system work.
2019-11-09 Integrated dual sensor operation with a scaled output
    Still needs to have conversion from (what I hope is) inches of water to knots. Other than that, everything is done.
    Has a bug: Clicking the buttons can cause the website to crash. Most likely this has something to do with the client requests not being read while the sensors are being polled.
2020-02-19 Added PCB files (#2)
    Just trying to make the PCB branch pretty
    [pcb project.brd, pcb project.sch]
2020-02-20 Trying to make arduino less upset
2020-05-15 Removed velocity calc, is toggle() a command?
    [91270A250_STL NONMARRING LOCKNUT WSPRING-LOCK WASHER.f3d, 92095A183_BUTTON HEAD HEX DRIVE SCREW.f3d, Adafruit ESP8266 Feather_withPinheads.f3d, Amphenol Pressure Sensor.f3d, Carbon Frame.f3d, DR Assembly V2.f3z, Free stream tube.f3d, Rake Body Drawing V2.f3z]
2020-06-03 Checkpoint: needs webpage formating fixed, parse data into buttons
    [main_code.ino]
2020-08-06 Finalized PCB design + wind tunnel analysis, MCU code still a mess
    [pcb project.brd, pcb project.sch]
2020-08-06 Cleaned up code, should compile, still broken
    [main_code.ino]
